MechanicalCat/HackyRacerPID/README.md

# HackyRacerPID
Arduino sketch to add a current-limiting closed-loop PID to an open-loop DC motor controller
